greatscottgadgets/urti-mainboard/README.md

# URTI Mainboard

This is the open source hardware design for the mainboard of URTI, the Universal Radio Test Instrument.

https://greatscottgadgets.com/urti/
