greatscottgadgets/urti-mainboard/mainboard.kicad_pcb

## KiCad design mainboard.kicad_pcb (2023-09-29)

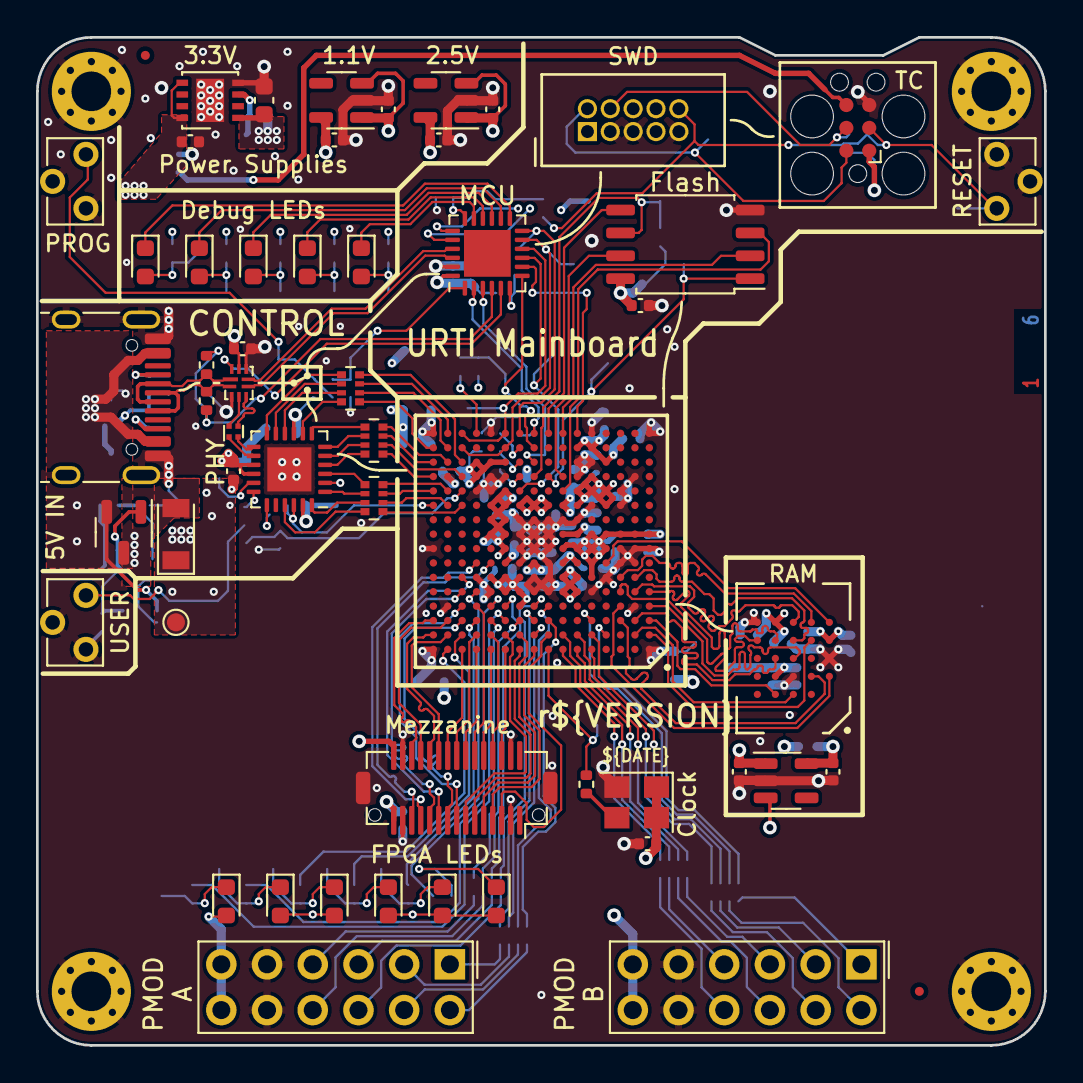
[picture p1: board mainboard.kicad_pcb from above]

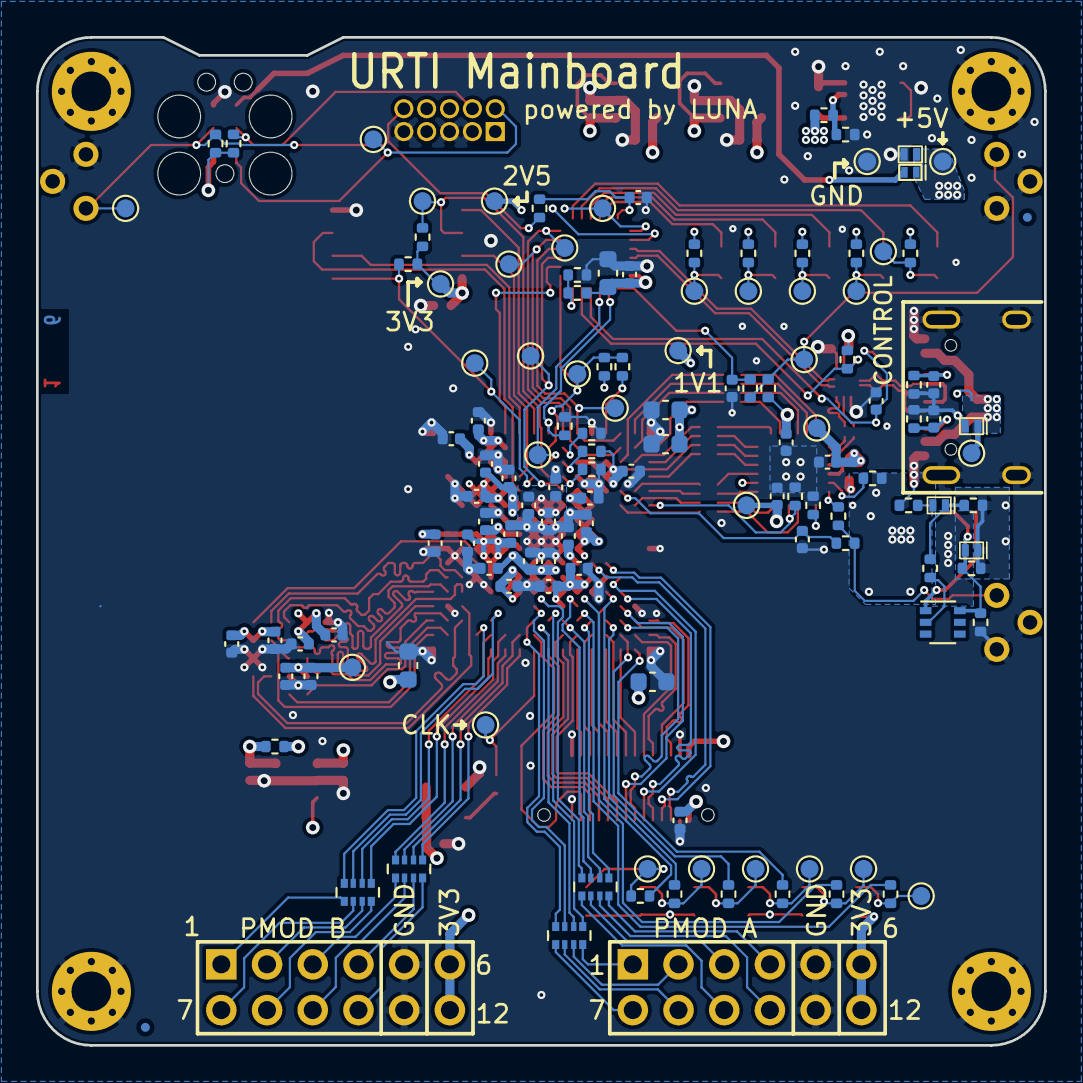
[picture p2: board mainboard.kicad_pcb from below]

Board: 6 copper layers, 56.0 x 56.0 mm, 190 parts (131 on the bottom side), 172 nets.

Parts:
C1, C3, C13, C15, C16, C21, C25, C26, C27, C28, C29, C30, C31, C32, C35, C36, C37, C38, C39, C40, C45, C46, C47, C48, C49, C52, C53, C54: 1uF; C_0402_1005Metric
C2, C8, C9, C19, C20, C34: 2.2uF; C_0603_1608Metric
C4, C10, C11, C12, C14, C17, C18, C22, C23, C24, C33, C41, C42, C43, C44, C50, C51, C55, C56: 0.1uF; C_0402_1005Metric
C5: 1nF; C_0402_1005Metric
C6, C7: 330pF; C_0402_1005Metric
D1: BLUE; LED_0603_1608Metric
D2: GREEN; LED_0603_1608Metric
D3: YELLOW; LED_0603_1608Metric
D4: ORANGE; LED_0603_1608Metric
D5: RED; LED_0603_1608Metric
D6: PURPLE; LED_0603_1608Metric
D7: SCHOTTKY; DSN1006-2
D8: TVS; DFN1006-2
D9: D; D_SOD-123FL
D10, D14: ICE BLUE; LED_0603_1608Metric
D11, D13: PINK; LED_0603_1608Metric
D12: WHITE; LED_0603_1608Metric
D15, D16: 6.2±2%; DFN1006-2
D17: 5.6±2%; DFN1006-2
FID1, FID2, FID3, FID4: Fiducial; Fiducial_0.5mm_Mask1mm
FL1: Filter_EMI_CommonMode; L_CommonModeChoke_Murata_DLM0NS
H1, H2, H3, H4: MountingHole; MountingHole_2.2mm_M2_Pad_Via
J1: USB_C; USB_C_Receptacle_HRO_TYPE-C-31-M-12
J2: MCU_SWD; SWD_CONNECTOR_LARGE_BOX
J3: TC_SWD; Tag-Connect_TC2030-IDC-FP_2x03_P1.27mm_Vertical
J4: PMOD_A; PinSocket_2x06_P2.54mm_PMOD
J5: PMOD_B; PinSocket_2x06_P2.54mm_PMOD
J6: MEZZANINE; Amphenol_10132798-03
Q1: PMOS; SOT-23-3
Q2: 2PNP; SOT-363_SC-70-6
R1: DNP; R_0402_1005Metric
R2, R4, R20, R31: 8.06k±1%; R_0402_1005Metric
R3, R7, R8, R12: 820k; R_0402_1005Metric
R5, R6, R21, R22, R27, R38: 10k; R_0402_1005Metric
R9, R10, R30, R36, R37, R40, R43: 5.1k; R_0402_1005Metric
R11, R15, R17, R33: 18.7k±1%; R_0402_1005Metric
R13, R14, R23: 33k; R_0402_1005Metric
R16: 57.6k±1%; R_0402_1005Metric
R18: 0; R_0402_1005Metric
R19: 20k; R_0402_1005Metric
R24, R25, R26: 1k; R_0402_1005Metric
R28, R29, R32, R34, R35, R42, R44: 2.2k; R_0402_1005Metric
R39, R41, R45: 330; R_0402_1005Metric
RN1, RN2, RN3: 330; R_Array_Convex_4x0402
RN4, RN5, RN6, RN7: 33; R_Array_Convex_4x0402
SW1: BTN_PROGRAM; SW_Tactile_SPST_Angled_TC-1109DE-B-F
SW2: BTN_RESET; SW_Tactile_SPST_Angled_TC-1109DE-B-F
SW3: BTN_USER; SW_Tactile_SPST_Angled_TC-1109DE-B-F
TP1, TP2, TP3, TP4, TP5, TP6, TP7, TP8, TP9, TP10, TP11, TP12, TP13, TP14, TP15, TP16, TP17, TP18, TP19, TP20, TP21, TP22, TP23, TP24, TP25, TP26, TP27, TP28, TP29, TP30, TP31, TP32, TP33, TP34: TestPoint; TestPoint_Pad_D1.0mm
U1: ECP5-BGA256; lattice_cabga256
U2: ATSAMD11; QFN-24-1EP_4x4mm_P0.5mm_EP2.6x2.6mm
U3: PI3USB102G; Diodes_10-TQFN_ZL
U4: 3V3REG; DFN-8-1EP_3x3mm_P0.65mm_EP1.55x2.4mm
U5: 1V15REG; SOT-23-5
U6: 2V5REG; SOT-23-5
U7: 1V8REG; SOT-23-5
U8: HyperRAM; BGA-24_5x5_6.0x8.0mm
U9: USB3343-CP; VQFN-24-1EP_4x4mm_P0.5mm_EP2.45x2.45mm
U10: W25Q32JVSS; SOIC-8_5.23x5.23mm_P1.27mm
Y1: Osc60MHz; Crystal_SMD_3225-4Pin_3.2x2.5mm

Connections:
+1V1: C8.1, C9.1, C10.1, C11.1, C12.1, C13.1, C14.1, C15.1, C35.1, TP9.1, U1.G6 (VCC_1), U1.G7 (VCC_2), U1.G9 (VCC_3), U1.L8 (VCC_4), U1.L9 (VCC_5), U1.L10 (VCC_6), U5.5 (VOUT)
+2V5: C16.1, C17.1, C18.1, C39.1, TP10.1, U1.G11 (VCCAUX_1), U1.L7 (VCCAUX_2), U6.5 (VOUT)
+3V3: C2.1, C3.1, C4.1, C19.1, C20.1, C21.1, C22.1, C23.1, C24.1, C25.1, C26.1, C27.1, C28.1, C29.1, C30.1, C33.1, C34.1, C37.1, C38.1, C48.1, C50.1, C51.1, C52.1, C55.1, C56.1, D1.2 (A), D2.2 (A), D3.2 (A), D4.2 (A), D5.2 (A), D6.2 (A), J2.1 (VTref), J3.1, J4.6, J4.12, J5.6, J5.12, J6.15, J6.16, R1.1, R3.1, R5.1, R6.1, R16.1, R18.1, R22.1, R30.1, R31.1, R32.1, R34.1, R35.1, R36.1, R37.1, R38.1, R40.2, R43.1, TP8.1, TP13.1, U1.D10 (PT47A), U1.E6 (PT20A), U1.E7 (PT24A), U1.E10 (PT47B), U1.E11 (PT51B), U1.F6 (VCCIO0_1), U1.F7 (VCCIO0_2), U1.F10 (VCCIO1_1), U1.F11 (VCCIO1_2), U1.F12 (PR8D), U1.H11 (VCCIO2_1), U1.J6 (VCCIO6_1), U1.J7 (VCCIO6_2), U1.J11 (VCCIO2_2), U1.J12 (PR17D), U1.K11 (VCCIO3_1), U1.K12 (PR29B), U1.L4 (PL29C), U1.L6 (VCCIO8), U1.L11 (VCCIO3_2), U1.L12 (PR29D), U1.M4 (PL35C), U1.M5 (PL44C), U1.M6 (PL47A), U1.M11 (PR47A), U1.N5 (PL44D), U1.N13 (PR38A), U1.P4 (PL41A), U1.P11 (PR47C), U1.P12 (PR47D), U1.P13 (PR41A), U1.R5 (PL44A), U1.R6 (D6/PB4B), U2.24 (VDD), U3.9 (VCC), U4.1 (OUT), U5.1 (VIN), U5.3 (EN), U6.1 (VIN), U6.3 (EN), U7.1 (VIN), U7.3 (EN), U9.2 (CLKOUT), U9.9 (VDDIO), U9.15 (VDD33), U9.16 (VBAT), U9.18 (ID), U10.8 (VCC), Y1.1 (EN), Y1.4 (VDD)
+5V: C36.1, D7.1 (K), D9.1 (K), D15.1 (K), R19.1, TP5.1, TP7.1, U4.5 (EN), U4.8 (IN)
/CONTROL Port/CONTROL PHY/CLK: RN3.8 (R1.2), U9.21 (REFCLK/XI)
/CONTROL Port/CONTROL PHY/D+: FL1.1, U9.14 (D+)
/CONTROL Port/CONTROL PHY/D-: FL1.3, U9.13 (D-)
/CONTROL Port/CONTROL PHY/DATA0: RN1.8 (R1.2), U9.4 (DATA0)
/CONTROL Port/CONTROL PHY/DATA1: RN1.7 (R2.2), U9.5 (DATA1)
/CONTROL Port/CONTROL PHY/DATA2: RN1.6 (R3.2), U9.6 (DATA2)
/CONTROL Port/CONTROL PHY/DATA3: RN1.5 (R4.2), U9.7 (DATA3)
/CONTROL Port/CONTROL PHY/DATA4: RN2.8 (R1.2), U9.8 (DATA4)
/CONTROL Port/CONTROL PHY/DATA5: RN2.7 (R2.2), U9.10 (DATA5)
/CONTROL Port/CONTROL PHY/DATA6: RN2.6 (R3.2), U9.11 (DATA6)
/CONTROL Port/CONTROL PHY/DATA7: RN2.5 (R4.2), U9.12 (DATA7)
/CONTROL Port/CONTROL PHY/DIR: RN3.6 (R3.2), U9.1 (DIR)
/CONTROL Port/CONTROL PHY/NXT: RN3.5 (R4.2), U9.3 (NXT)
/CONTROL Port/CONTROL PHY/PHY_D+: FL1.2, U3.4 (1D-)
/CONTROL Port/CONTROL PHY/PHY_D-: FL1.4, U3.5 (1D+)
/CONTROL Port/CONTROL PHY/RBIAS: R20.2, U9.19 (RBIAS)
/CONTROL Port/CONTROL PHY/STP: RN3.7 (R2.2), U9.24 (STP)
/CONTROL Port/CONTROL PHY/VBUS_SENSE: R19.2, U9.17 (VBUS)
/CONTROL Port/CONTROL PHY/VDD18: C49.1, TP12.1, U9.23 (VDD18)
/CONTROL Port/CONTROL_CC1: C6.1, J1.A5 (CC1), R9.2
/CONTROL Port/CONTROL_CC2: C7.1, J1.B5 (CC2), R10.2
/CONTROL Port/CONTROL_D+: J1.A6 (D+), J1.B6 (D+), R8.2, U3.2 (D-)
/CONTROL Port/CONTROL_D-: J1.A7 (D-), J1.B7 (D-), R7.1, U3.1 (D+)
/CONTROL Port/CONTROL_MCU_D+: U2.22 (PA25), U3.6 (2D-)
/CONTROL Port/CONTROL_MCU_D-: U2.21 (PA24), U3.7 (2D+)
/CONTROL Port/CONTROL_PHY.CLK: RN3.1 (R1.1), U1.L14 (PR32C)
/CONTROL Port/CONTROL_PHY.DATA0: RN1.1 (R1.1), U1.N16 (PR32A)
/CONTROL Port/CONTROL_PHY.DATA1: RN1.2 (R2.1), U1.N14 (PR35D)
/CONTROL Port/CONTROL_PHY.DATA2: RN1.3 (R3.1), U1.P16 (PR35A)
/CONTROL Port/CONTROL_PHY.DATA3: RN1.4 (R4.1), U1.P15 (PR32B)
/CONTROL Port/CONTROL_PHY.DATA4: RN2.1 (R1.1), U1.R16 (PR35B)
/CONTROL Port/CONTROL_PHY.DATA5: RN2.2 (R2.1), U1.R15 (PR38C)
/CONTROL Port/CONTROL_PHY.DATA6: RN2.3 (R3.1), U1.T15 (PR38D)
/CONTROL Port/CONTROL_PHY.DATA7: RN2.4 (R4.1), U1.P14 (PR38B)
/CONTROL Port/CONTROL_PHY.DIR: RN3.3 (R3.1), U1.M16 (PR26C)
/CONTROL Port/CONTROL_PHY.NXT: RN3.4 (R4.1), U1.M15 (PR26D)
/CONTROL Port/CONTROL_PHY.STP: RN3.2 (R2.1), U1.L15 (PR26B)
/CONTROL Port/CONTROL_PHY.~RESET: R21.1, U1.L16 (PR26A), U9.22 (RESET)
/CONTROL Port/CONTROL_RESET_DETECT: C5.1, R7.2, R8.1, U2.4 (PA05)
/CONTROL Port/CONTROL_SWITCH: R6.2, U2.5 (PA06), U3.10 (S)
/Clock and Miscellaneous/CLOCK_60MHZ: R45.1, TP34.1, U1.A8 (PT29B)
/Debugger/FPGA_ADV: U1.T6 (D7/PB4A), U2.8 (PA09/XOUT)
/Debugger/FPGA_CONFIG.DONE: TP32.1, U1.P9 (DONE), U2.3 (PA04)
/Debugger/FPGA_CONFIG.~INIT: R42.1, U1.T9 (INITN), U2.2 (PA03)
/Debugger/FPGA_CONFIG.~PROGRAM: R43.2, R44.1, TP33.1, U1.R9 (PROGRAMN), U2.7 (PA08/XIN)
/Debugger/FPGA_JTAG.TCK: TP28.1, U1.T10 (TCK), U2.12 (PA15)
/Debugger/FPGA_JTAG.TDI: TP31.1, U1.R11 (TDI), U1.R14 (PR41B), U2.11 (PA14)
/Debugger/FPGA_JTAG.TDO: TP30.1, U1.M10 (TDO), U2.9 (PA10)
/Debugger/FPGA_JTAG.TMS: TP29.1, U1.T11 (TMS), U1.T14 (PR41D), U2.10 (PA11)
/Debugger/LED10: D10.1 (K), U2.13 (PA16)
/Debugger/LED11: D11.1 (K), U2.14 (PA17)
/Debugger/LED12: D12.1 (K), U2.15 (PA22)
/Debugger/LED13: D13.1 (K), U2.16 (PA23)
/Debugger/LED14: D14.1 (K), U2.17 (PA27)
/Debugger/MCU_SWDCLK: J2.4 (SWDCLK/TCK), J3.4, R5.2, TP2.1, U2.19 (PA30/SWCLK)
/Debugger/MCU_SWDIO: J2.2 (SWDIO/TMS), J3.2, TP3.1, U2.20 (PA31/SWDIO)
/Debugger/~BTN_PROGRAM: C54.1, R33.1, U2.1 (PA02)
/Debugger/~BTN_RESET: J2.10 (~RESET), J3.3, R3.2, R4.1, SW2.1, TP1.1
/Expansion Interfaces/A0: J4.1, RN4.8 (R1.2)
/Expansion Interfaces/A1: J4.2, RN4.7 (R2.2)
/Expansion Interfaces/A2: J4.3, RN5.6 (R3.2)
/Expansion Interfaces/A3: J4.4, RN5.8 (R1.2)
/Expansion Interfaces/A4: J4.7, RN4.5 (R4.2)
/Expansion Interfaces/A5: J4.8, RN4.6 (R3.2)
/Expansion Interfaces/A6: J4.9, RN5.5 (R4.2)
/Expansion Interfaces/A7: J4.10, RN5.7 (R2.2)
/Expansion Interfaces/B0: J5.1, RN7.5 (R4.2)
/Expansion Interfaces/B1: J5.2, RN7.7 (R2.2)
/Expansion Interfaces/B2: J5.3, RN6.5 (R4.2)
/Expansion Interfaces/B3: J5.4, RN6.7 (R2.2)
/Expansion Interfaces/B4: J5.7, RN7.6 (R3.2)
/Expansion Interfaces/B5: J5.8, RN7.8 (R1.2)
/Expansion Interfaces/B6: J5.9, RN6.6 (R3.2)
/Expansion Interfaces/B7: J5.10, RN6.8 (R1.2)
/Expansion Interfaces/MEZZANINE3: J6.3, U1.B8 (PT35B)
/Expansion Interfaces/MEZZANINE4: J6.4, U1.A9 (PT42A)
/Expansion Interfaces/MEZZANINE5: J6.5, U1.B10 (PT44A)
/Expansion Interfaces/MEZZANINE6: J6.6, U1.A10 (PT42B)
/Expansion Interfaces/MEZZANINE7: J6.7, U1.B11 (PT49A)
/Expansion Interfaces/MEZZANINE8: J6.8, U1.D14 (PR2D)
/Expansion Interfaces/MEZZANINE9: J6.9, U1.C14 (PR2C)
/Expansion Interfaces/MEZZANINE10: J6.10, U1.F14 (PR5D)
/Expansion Interfaces/MEZZANINE11: J6.11, U1.E14 (PR5C)
/Expansion Interfaces/MEZZANINE12: J6.12, U1.G13 (PR11B)
/Expansion Interfaces/MEZZANINE13: J6.13, U1.G12 (PR11A)
/Expansion Interfaces/MEZZANINE18: J6.18, U1.C16 (PR5A)
/Expansion Interfaces/MEZZANINE19: J6.19, U1.C15 (PR5B)
/Expansion Interfaces/MEZZANINE20: J6.20, U1.B16 (PR2A)
/Expansion Interfaces/MEZZANINE21: J6.21, U1.B15 (PR2B)
/Expansion Interfaces/MEZZANINE22: J6.22, U1.A14 (PT65B)
/Expansion Interfaces/MEZZANINE23: J6.23, U1.B13 (PT60A)
/Expansion Interfaces/MEZZANINE24: J6.24, U1.A13 (PT65A)
/Expansion Interfaces/MEZZANINE25: J6.25, U1.D13 (PT62A)
/Expansion Interfaces/MEZZANINE26: J6.26, U1.A12 (PT53B)
/Expansion Interfaces/MEZZANINE27: J6.27, U1.B12 (PT56A)
/Expansion Interfaces/MEZZANINE28: J6.28, U1.A11 (PT53A)
/Expansion Interfaces/PMOD_A0: RN4.1 (R1.1), U1.C9 (PT38B)
/Expansion Interfaces/PMOD_A1: RN4.2 (R2.1), U1.B9 (PT38A)
/Expansion Interfaces/PMOD_A2: RN5.3 (R3.1), U1.D11 (PT51A)
/Expansion Interfaces/PMOD_A3: RN5.1 (R1.1), U1.C12 (PT56B)
/Expansion Interfaces/PMOD_A4: RN4.4 (R4.1), U1.C8 (PT35A)
/Expansion Interfaces/PMOD_A5: RN4.3 (R3.1), U1.D8 (PT33B)
/Expansion Interfaces/PMOD_A6: RN5.4 (R4.1), U1.D9 (PT40A)
/Expansion Interfaces/PMOD_A7: RN5.2 (R2.1), U1.C10 (PT44B)
/Expansion Interfaces/PMOD_B0: RN7.4 (R4.1), U1.B4 (PT11B)
/Expansion Interfaces/PMOD_B1: RN7.2 (R2.1), U1.B5 (PT15B)
/Expansion Interfaces/PMOD_B2: RN6.4 (R4.1), U1.B6 (PT22B)
/Expansion Interfaces/PMOD_B3: RN6.2 (R2.1), U1.B7 (PT27B)
/Expansion Interfaces/PMOD_B4: RN7.3 (R3.1), U1.C5 (PT15A)
/Expansion Interfaces/PMOD_B5: RN7.1 (R1.1), U1.A5 (PT18A)
/Expansion Interfaces/PMOD_B6: RN6.3 (R3.1), U1.A6 (PT18B)
/Expansion Interfaces/PMOD_B7: RN6.1 (R1.1), U1.A7 (PT29A)
/FPGA Bank 8 and Configuration Flash/D0: U1.T8 (D0/PICO/PB11B), U10.5 (DI(IO0))
/FPGA Bank 8 and Configuration Flash/D1: U1.T7 (D1/POCI/PB11A), U10.2 (DO(IO1))
/FPGA Bank 8 and Configuration Flash/D2: U1.M7 (D2/PB9B), U10.3 (IO2)
/FPGA Bank 8 and Configuration Flash/D3: U1.N7 (D3/PB9A), U10.7 (IO3)
/FPGA Bank 8 and Configuration Flash/FPGA_CFG0: R39.1, U1.N10 (CFG_0)
/FPGA Bank 8 and Configuration Flash/FPGA_CFG1: R40.1, U1.P10 (CFG_1)
/FPGA Bank 8 and Configuration Flash/FPGA_CFG2: R41.1, U1.R10 (CFG_2)
/FPGA Bank 8 and Configuration Flash/FPGA_FLASH_CLK: R37.2, TP26.1, U1.N9 (MCLK/SCLK/CCLK), U10.6 (CLK)
/FPGA Bank 8 and Configuration Flash/~CS_DI: R38.2, TP27.1, U1.N8 (HOLDN/DI/PB15A), U10.1 (~CS)
/FPGA Bank 8 and Configuration Flash/~FPGA_SELF_PROGRAM: R44.2, U1.T13 (PR44B)
/FPGA Banks 0 and 1/LED0: R29.2, U1.E13 (PT62B)
/FPGA Banks 0 and 1/LED1: R28.2, U1.C13 (PT60B)
/FPGA Banks 0 and 1/LED2: R27.2, U1.B14 (PT67A)
/FPGA Banks 0 and 1/LED3: R26.2, U1.A15 (PT67B)
/FPGA Banks 0 and 1/LED4: R25.2, U1.D12 (PT58A)
/FPGA Banks 0 and 1/LED5: R24.2, U1.C11 (PT49B)
/FPGA Banks 2 and 3/~BTN_USER: C53.1, R23.1, U1.M14 (PR32D)
/FPGA Banks 6 and 7/RAM.CK: U1.C3 (PL2C), U8.B2 (CK)
/FPGA Banks 6 and 7/RAM.DQ0: U1.F2 (PL11C), U8.D3 (DQ0)
/FPGA Banks 6 and 7/RAM.DQ1: U1.B1 (PL2A), U8.D2 (DQ1)
/FPGA Banks 6 and 7/RAM.DQ2: U1.C2 (PL5B), U8.C4 (DQ2)
/FPGA Banks 6 and 7/RAM.DQ3: U1.E1 (PL11D), U8.D4 (DQ3)
/FPGA Banks 6 and 7/RAM.DQ4: U1.E3 (PL5C), U8.D5 (DQ4)
/FPGA Banks 6 and 7/RAM.DQ5: U1.E2 (PL8B), U8.E3 (DQ5)
/FPGA Banks 6 and 7/RAM.DQ6: U1.F3 (PL5D), U8.E2 (DQ6)
/FPGA Banks 6 and 7/RAM.DQ7: U1.G4 (PL11B), U8.E1 (DQ7)
/FPGA Banks 6 and 7/RAM.RWDS: U1.D1 (PL8A), U8.C3 (RWDS)
/FPGA Banks 6 and 7/RAM.~CK: U1.D3 (PL2D), U8.B1 (~CK)
/FPGA Banks 6 and 7/RAM.~CS: U1.B2 (PL2B), U8.A3 (~CS)
/FPGA Banks 6 and 7/RAM.~RESET: U1.C1 (PL5A), U8.A4 (~RESET)
CONTROL_VBUS: D8.1 (K), D16.1 (K), J1.A4 (VBUS), J1.A9 (VBUS), J1.B4 (VBUS), J1.B9 (VBUS), Q1.2 (S), Q2.1 (E1), R11.1, R12.1, TP4.1
GND: C1.2, C2.2, C3.2, C4.2, C5.2, C6.2, C7.2, C8.2, C9.2, C10.2, C11.2, C12.2, C13.2, C14.2, C15.2, C16.2, C17.2, C18.2, C19.2, C20.2, C21.2, C22.2, C23.2, C24.2, C25.2, C26.2, C27.2, C28.2, C29.2, C30.2, C31.2, C32.2, C33.2, C34.2, C35.2, C36.2, C37.2, C38.2, C39.2, C40.2, C41.2, C42.2, C43.2, C44.2, C45.2, C46.2, C47.2, C48.2, C49.2, C50.2, C51.2, C52.2, C53.2, C54.2, C55.2, C56.2, D8.2 (A), D15.2 (A), H1.1, H2.1, H3.1, H4.1, J1.A1 (GND), J1.A12 (GND), J1.B1 (GND), J1.B12 (GND), J1.S1 (SHIELD), J2.3 (GND), J2.5 (GND), J2.9 (GNDDetect), J3.5, J4.5, J4.11, J5.5, J5.11, J6.2, J6.14, J6.17, J6.29, J6.MP (MountPin), R2.2, R9.1, R10.1, R14.2, R15.2, R17.2, R20.1, R21.2, R39.2, R41.2, R42.2, SW1.2, SW1.3 (SHIELD), SW2.2, SW2.3 (SHIELD), SW3.2, SW3.3 (SHIELD), TP6.1, U1.A1 (GND_1), U1.A16 (GND_2), U1.D2 (GND_3), U1.D15 (GND_4), U1.E5 (PT13A), U1.E8 (PT33A), U1.E9 (PT40B), U1.E12 (PT58B), U1.F4 (PL8C), U1.F8 (GND_5), U1.F9 (GND_6), U1.F13 (PR8C), U1.G2 (PL14B), U1.G3 (PL14C), U1.G8 (GND_7), U1.G10 (GND_8), U1.H1 (GND_9), U1.H2 (PL20B), U1.H3 (PL14D), U1.H8 (GND_10), U1.H9 (GND_11), U1.H10 (GND_12), U1.H16 (GND_13), U1.J8 (GND_14), U1.J9 (GND_15), U1.J10 (GND_16), U1.K6 (GND_17), U1.K7 (GND_18), U1.K8 (GND_19), U1.K9 (GND_20), U1.K10 (GND_21), U1.L3 (PL32C), U1.L5 (PL29D), U1.M3 (PL32D), U1.M12 (PR44C), U1.M13 (PR35C), U1.N2 (GND_22), U1.N6 (PL47B), U1.N11 (PR47B), U1.N12 (PR44D), U1.N15 (GND_23), U1.P5 (PL47D), U1.P6 (PL47C), U1.T1 (GND_24), U1.T5 (GND_25), U1.T12 (GND_26), U1.T16 (GND_27), U2.23 (GND), U3.3 (GND), U3.8 (~OE), U4.4 (GND), U4.9 (GND), U5.2 (GND), U6.2 (GND), U7.2 (GND), U8.B3 (VSS), U8.C1 (VSSQ), U8.E5 (VSSQ), U9.25 (GND), U10.4 (GND), Y1.2 (GND)
unnamed: D1.1 (K), R28.1, TP18.1
unnamed: D2.1 (K), R27.1, TP17.1
unnamed: D3.1 (K), R26.1, TP16.1
unnamed: D4.1 (K), R25.1, TP15.1
unnamed: D5.1 (K), R24.1, TP14.1
unnamed: D6.1 (K), R29.1, TP19.1
unnamed: D7.2 (A), J3.6
unnamed: D9.2 (A), Q1.3 (D)
unnamed: D10.2 (A), R30.2, TP21.1
unnamed: D11.2 (A), R32.2, TP22.1
unnamed: D12.2 (A), R34.2, TP23.1
unnamed: D13.2 (A), R35.2, TP24.1
unnamed: D14.2 (A), R36.2, TP25.1
unnamed: D16.2 (A), Q1.1 (G), Q2.6 (C1), R12.2, R14.1
unnamed: D17.2 (A), R15.1
unnamed: D17.1 (K), R11.2, R13.2
unnamed: Q2.2 (B1), R13.1
unnamed: R22.2, R23.2, SW3.1
unnamed: R31.2, R33.2, SW1.1, TP20.1
unnamed: R1.2, R2.1, U2.6 (PA07)
unnamed: C1.1, R4.2, U2.18 (PA28/~RST)
unnamed: R16.2, R17.1, U4.3 (ADJ/NC)
unnamed: R45.2, Y1.3 (OUT)
VCCRAM: C31.1, C32.1, C40.1, C41.1, C42.1, C43.1, C44.1, C45.1, C46.1, C47.1, R18.2, TP11.1, U1.F5 (PL8D), U1.G5 (PL11A), U1.H4 (PL17B), U1.H5 (PL17A), U1.H6 (VCCIO7_1), U1.H7 (VCCIO7_2), U1.J1 (PL23A), U1.J2 (PL23B), U1.J3 (PL20C), U1.J4 (PL17C), U1.J5 (PL17D), U7.5 (VOUT), U8.B4 (VCC), U8.D1 (VCCQ), U8.E4 (VCCQ)
