greatscottgadgets/urti-mainboard/(threads)

Thread 2 (2024-05-01):

TX balun lacks DC block

mossmann, 2024-05-01:
Balun T4 pin 1 is shorted to GND, but there should be a capacitor between pin 1 and GND. It is possible but tricky to bodge in a capacitor by cutting the GND trace and soldering a 33 pF 0201 capacitor in its place.

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

An untested bodge that might be easier would be to cut both traces between U13 and L10 (unpopulated), scrape away some solder mask, move T4 there, and then install two 33 pF 0201 capacitors onto the original T4 footprint.

An easier workaround with degraded RF performance is to cut the GND trace without installing a capacitor. This results in reduced TX output power at the intended frequency and increased LO leakage.

mossmann, 2024-05-01:
The root cause of this is that the schematic symbol for T3 and T4 was drawn with an incorrect topology.

Thread 3 (2024-05-01):

Analog supply regulator does not support sufficient current

mossmann, 2024-05-01:
3V3A regulator U24 can shut down due to an over-current or over-temperature condition when operating the radio in full-duplex mode.

As a workaround, operate in half-duplex mode and turn on either the TX power switch or the RX power switch but not both.

Full-duplex mode appears to work if the front-end mixers are disabled, so full-duplex operation is possible over a limited frequency range.

Thread 4 (2024-09-09):

Add clock input

mossmann, 2024-09-09:
The central clock in r0.1.0 is a 40 MHz TCXO. We want to add the ability to discipline the clock with an external reference clock.

This could be done by switching to a VCXO or VCTCXO such as TXEAACSANF-40.000000 or TG2520SMN 40.0000M-CCGNDM5 and using the FPGA to implement a control loop.

We could potentially roll our own VCXO. See:
- https://www.maximintegrated.com/en/design/technical-documents/app-notes/2/2097.html
- https://www.raltron.com/webproducts/technical/technical_notes/COMMON-SENSE-OSCILLATOR-TECHNIQUES.pdf

It could even be possible to build our own OCXO with a heating resistor under an RF shield, but we probably wouldn't want to do that on battery power.

Another option would be to use a clock generator such as Si5351C. This would be an easy way to add a great deal of flexibility to the clock architecture, but it would also add phase noise. Si5351C is used on HackRF One. The phase noise there is acceptable, but we hope to achieve lower phase noise with URTI. Other clock generators we've found in the same price range have higher phase noise than Si5351C. See: https://github.com/greatscottgadgets/lab-notes/tree/main/project-reports/2023-06-02-urti-progress-report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

Thread 5 (2024-09-09):

Add image reject filters

mossmann, 2024-09-09:
As seen to the right of the RFFC5072 mixers in the block diagram: https://github.com/greatscottgadgets/lab-notes/tree/main/project-reports/2023-06-02-urti-progress-report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

This is very similar to the filter section in HackRF One where we have two SP3T switches that provide three paths: high-pass, low-pass, and band-pass. The band-pass path could be straight-through without an actual filter.

We could use off-the-shelf filters as in HackRF, or we could design lumped element filters. We might consider chaining two or more filters in order to achieve a sharper cut-off.

Potentially we could add more paths with tighter filters, increasing the ability to filter out additional mixer products and out-of-band blocker signals, but three paths is our minimum requirement.

A HackRF-like design would be a good place to start.

Thread 6 (2024-09-09):

Add TX amplifier

mossmann, 2024-09-09:
See mainboard block diagram: https://github.com/greatscottgadgets/lab-notes/tree/main/project-reports/2023-06-02-urti-progress-report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

This could be a single component with an externally switched bypass path, similar to the design in HackRF One, at least for the initial implementation.

We'll likely want to test candidate components to measure performance on our stack-up over our wide range of operating frequencies.

We will want to be able to guarantee the capability of achieving a certain output power, perhaps 0 dBm, across the whole frequency range.

We might consider two or more separate amplifiers for different frequency ranges. Another option might be a single wideband amplifier plus a secondary (chained) amplifier used only for high frequencies.

Thread 7 (2024-09-09):

A

mossmann, 2024-09-09:
See mainboard block diagram: https://github.com/greatscottgadgets/lab-notes/tree/main/project-reports/2023-06-02-urti-progress-report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

This could be a single component with an externally switched bypass path, similar to the design in HackRF One, at least for the initial implementation.

We'll likely want to test candidate components to measure performance on our stack-up over our wide range of operating frequencies.

We will want to be able to guarantee the capability of achieving a certain output power, perhaps 0 dBm, across the whole frequency range.

We might consider two or more separate amplifiers for different frequency ranges. Another option might be a single wideband amplifier plus a secondary (chained) amplifier used only for high frequencies.
