greatscottgadgets/urti-mainboard/(commit log)

2023-09-29 First commit, derived from Cynthion r1.3.0
    [bank0_1.kicad_sch, bank2_3.kicad_sch, bank6_7.kicad_sch, bank8_configuration.kicad_sch, clock_misc.kicad_sch, control_port.kicad_sch, debugger.kicad_sch, expansion.kicad_sch]
2024-01-17 Add radio transceiver
    Remove Cynthion-specific features
    [analog_supplies.kicad_sch, bank0_1.kicad_sch, bank2_3.kicad_sch, bank6_7.kicad_sch, bank8_configuration.kicad_sch, clock_misc.kicad_sch, control_port.kicad_sch, debugger.kicad_sch]
2024-01-19 Update mcu pin assignments to support fast JTAG
    [debugger.kicad_sch]
2024-02-26 Add missing solder mask apertures
2024-02-26 Replace open drain clock inverters with push-pull
    [analog_supplies.kicad_sch, bank0_1.kicad_sch, bank2_3.kicad_sch, bank6_7.kicad_sch, bank8_configuration.kicad_sch, clock_misc.kicad_sch, digital_supplies.kicad_sch, expansion.kicad_sch]
2024-02-27 Tune slow-start capacitors
    [analog_supplies.kicad_sch, digital_supplies.kicad_sch]
2024-02-27 Tune clock passives
    [clock_misc.kicad_sch, mixer.kicad_sch, radio.kicad_sch, rx.kicad_sch, tx.kicad_sch]
