greatscottgadgets/urti-mainboard/(notices)

Notices in the files:
clock_misc.kicad_sch:
Copyright 2023 Great Scott Gadgets
indicators_buttons.kicad_sch:
Licensed under the CERN-OHL-P v2
